EXiciuTE/Gaus-Beschleuniger/production/BOM_Overview.xlsx

Reference | Qty | Value | Footprint | Voltage | MPN | LCSC_Part_# | STATUS
A1 | 1 | Arduino_Nano_v3.x | Module:Arduino_Nano |  |  |  | home
BT1 | 1 | Battery | Connector_AMASS:AMASS_XT60-M_1x02_P7.20mm_Vertical |  |  | C5334533 | home
C1,C2,C3,C4,C5,C6,C7,C8 | 8 | 1000uF | Capacitor_THT:CP_Radial_D35.0mm_P10.00mm_SnapIn |  | ESMR401VSN102MA50S | C1589731 | digikey
C9,C13 | 2 | 100n | Capacitor_SMD:C_0805_2012Metric_Pad1.18x1.45mm_HandSolder | 100V | CL21B104KCFNNNE | C28233 | PCBA
C10,C11,C12 | 3 | 1u | Capacitor_SMD:C_1206_3216Metric_Pad1.33x1.80mm_HandSolder | 100V | CL31B105KCHNNNE | C13832 | PCBA
C14,C15 | 2 | 22u | Capacitor_SMD:C_0805_2012Metric_Pad1.18x1.45mm_HandSolder | 10V | GRM21BR61A226ME44L | C441864 | PCBA
C16,C17,C18,C19,C20,C21 | 6 | 4u7 | Capacitor_SMD:C_1206_3216Metric_Pad1.33x1.80mm_HandSolder | 50V | CL31B475KBHNNNE | C51205 | PCBA
C22 | 1 | 100p | Capacitor_SMD:C_0603_1608Metric_Pad1.08x0.95mm_HandSolder | 50V | C0603C101J5GACTU | C2167328 | digikey
C23,C24,C25 | 3 | 100u 35V | Capacitor_THT:CP_Radial_D6.3mm_P2.50mm |  | 35ZLH100MEFC6.3X11 | C109392 | PCBA
C26 | 1 | 1000pF | Capacitor_SMD:C_1206_3216Metric_Pad1.33x1.80mm_HandSolder | 1000V | CC1206KKX7RDBB102 | C23631 | digikey
D1 | 1 | SM6T36A | Diode_SMD:D_SMB |  | SM6T36A | C7436537 | digikey
D2,D3,D6,D9,D11,D13,D17,D19,D20,D21,D22 | 11 | LED red | LED_THT:LED_D5.0mm |  | 151051RS11000 |  | digikey
D4,D15 | 2 | Q_SCR_KAG | Package_TO_SOT_THT:TO-247-3_Horizontal_TabDown |  | 70TPS12 | C335786 | home
D5,D25 | 2 | MURS160 | Diode_SMD:D_SMB_Handsoldering |  | MURS160 | C16378 | PCBA
D7,D8,D10,D12 | 4 | 940nm | LED_THT:LED_SideEmitter_Rectangular_W4.5mm_H1.6mm |  | LTE-302-M | C6980548 | digikey
D16 | 1 | US2M_HF | Diode_SMD:D_SMB_Handsoldering | 1000V | US2M_HF | C17247425 | digikey
D18 | 1 | 1N5340BG 6V | Diode_THT:D_DO-201_P15.24mm_Horizontal |  | 1N5340BG | C232444 | digikey
D24 | 1 | D_Schottky | Diode_SMD:D_SOD-123 |  | B0540W-7-F | C154764 | digikey
J1,J2,J3,J4,J5,J6 | 6 | Conn_01x02 | Connector_PinHeader_2.54mm:PinHeader_1x02_P2.54mm_Vertical,Connector_Wire:SolderWire-1sqmm_1x02_P5.4mm_D1.4mm_OD2.7mm |  |  |  | home
J7 | 1 | Screw_Terminal_01x02 | TerminalBlock_Phoenix:TerminalBlock_Phoenix_MKDS-1,5-2-5.08_1x02_P5.08mm_Horizontal |  |  |  | home
J8,J10 | 2 | Conn_01x04 | Connector_PinHeader_2.54mm:PinHeader_1x04_P2.54mm_Vertical |  |  |  | home
J9,J11,J13 | 3 | Conn_01x03 | Connector_PinHeader_2.54mm:PinHeader_1x03_P2.54mm_Vertical |  |  |  | home
J12 | 1 | Conn_01x04_Socket | Connector_PinSocket_2.54mm:PinSocket_1x04_P2.54mm_Vertical |  |  |  | home
L1 | 1 | L | Inductor_SMD:L_Bourns_SRN6045TA |  | SRN6045-150M | C3224592 | digikey
Q1,Q2 | 2 | Q_NMOS_GDS | Package_TO_SOT_SMD:SOT-223-3_TabPin2 |  | IPN60R3K4CEATMA1 |  | digikey
Q3,Q4,Q5,Q6 | 4 | 940nm | OptoDevice:Osram_LPT80A |  | PT908-7B-F | C17179478 | digikey
Q9 | 1 | IRF7493 | Package_SO:SOIC-8_3.9x4.9mm_P1.27mm |  | IRF7493 | C13914 | digikey
R1,R3,R6,R7,R10,R11,R13,R15,R17,R20,R24,R30,R31,R32,R33,R34,R35,R36,R37,R38,R41,R42 | 22 | 10k | Resistor_SMD:R_0805_2012Metric_Pad1.20x1.40mm_HandSolder |  | RC0805FR-0710KL | C84376 | PCBA
R2 | 1 | 88k7 | Resistor_SMD:R_0805_2012Metric_Pad1.20x1.40mm_HandSolder |  | RC0805FR-0788K7L | C273823 | PCBA
R4,R9,R18,R19 | 4 | 470k | Resistor_THT:R_Axial_DIN0207_L6.3mm_D2.5mm_P10.16mm_Horizontal |  | RNV14FAL470K | C2642472 | digikey
R5,R12,R14,R16,R39,R40 | 6 | 1k | Resistor_SMD:R_0805_2012Metric_Pad1.20x1.40mm_HandSolder |  | RC0805FR-101KL | C5842544 | digikey
R8,R23 | 2 | 2k | Resistor_THT:R_Axial_Power_L48.0mm_W12.5mm_P60.96mm |  | SQP10AJB-2K | C20166277 | digikey
R25 | 1 | 22k1 | Resistor_SMD:R_0805_2012Metric_Pad1.20x1.40mm_HandSolder |  | AC0805FR-0722K1L | C228640 | PCBA
R26 | 1 | 12mR | Resistor_SMD:R_1206_3216Metric_Pad1.30x1.75mm_HandSolder |  | PA1206FRE7W0R012Z | C7023635 | digikey
R27 | 1 | 43k | Resistor_SMD:R_0603_1608Metric_Pad0.98x0.95mm_HandSolder |  | RC0603FR-0743KL | C137719 | PCBA
R28 | 1 | 2k49 | Resistor_SMD:R_0603_1608Metric_Pad0.98x0.95mm_HandSolder |  | RC0603FR-132K49L | C4210186 | digikey
R29 | 1 | 60k4 | Resistor_SMD:R_0603_1608Metric_Pad0.98x0.95mm_HandSolder |  | RC0603FR-0760K4L | C165742 | PCBA
SW1,SW2 | 2 | SW_SPDT | 00_Library:Toggle_Switch_SPDT_PCB |  | SW-T2-2E-A-A2-M1 | C4950128 | digikey
SW4,SW5,SW6 | 3 | SW_Omron_B3FS | Button_Switch_THT:SW_TH_Tactile_Omron_B3F-10xx |  | B3F-1000 | C93157 | digikey
TR1 | 1 | Wuerth_750032052 | 00_Library:T_Wurth_WE-FB3751-EFD20 |  | 750032052 |  | digikey
U1 | 1 | LMR50410 | Package_TO_SOT_SMD:SOT-23-6 |  | LMR50410XDBVR | C2841056 | PCBA
U2 | 1 | LT3750 | Package_SO:MSOP-10_3x3mm_P0.5mm |  | LT3750 | C580129 | PCBA
Display | 1 |  |  |  |  | Kosten
Spannungsanzeige | 1 |  |  |  |  | PCB+PCBA | 110 € | mit allem
 |  |  |  |  |  | Digikey
 |  |  |  |  |  | Aliexpress
