EXiciuTE/Gaus-Beschleuniger/production/not_on_lcsc.xlsx

nicht verfügbar
D16
R4,R9,R18,R19
R8,R23
R26
R28
SW1,SW2
rote leds
D7,D8,D10,D12
Q1,Q2
Q3,Q4,Q5,Q6
TR1
die dicken Cs
lieber manuell machen, da pro komponente 2,60€ anfallen für PNP wechsel
C26
D1
D18
D24
L1
Q9
SW4,SW5,SW6
C22
