EXiciuTE/Gaus-Beschleuniger/toggle-switch-pcb-mounted-spdt-dpdt-3way-1.snapshot.20/Mounting Plyate.step

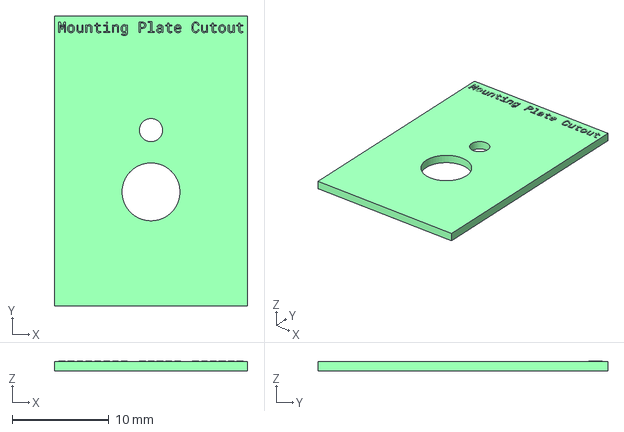
[picture p5: CAD file, 2025-11-15]
toggle-switch-pcb-mounted-spdt-dpdt-3way-1.snapshot.20/Mounting Plyate.step
20.0 x 30.0 x 1.05 mm
