EXiciuTE/Gaus-Beschleuniger/Gaus-Beschleuniger.kicad_pcb

## KiCad design Gaus-Beschleuniger.kicad_pcb (2025-11-22)

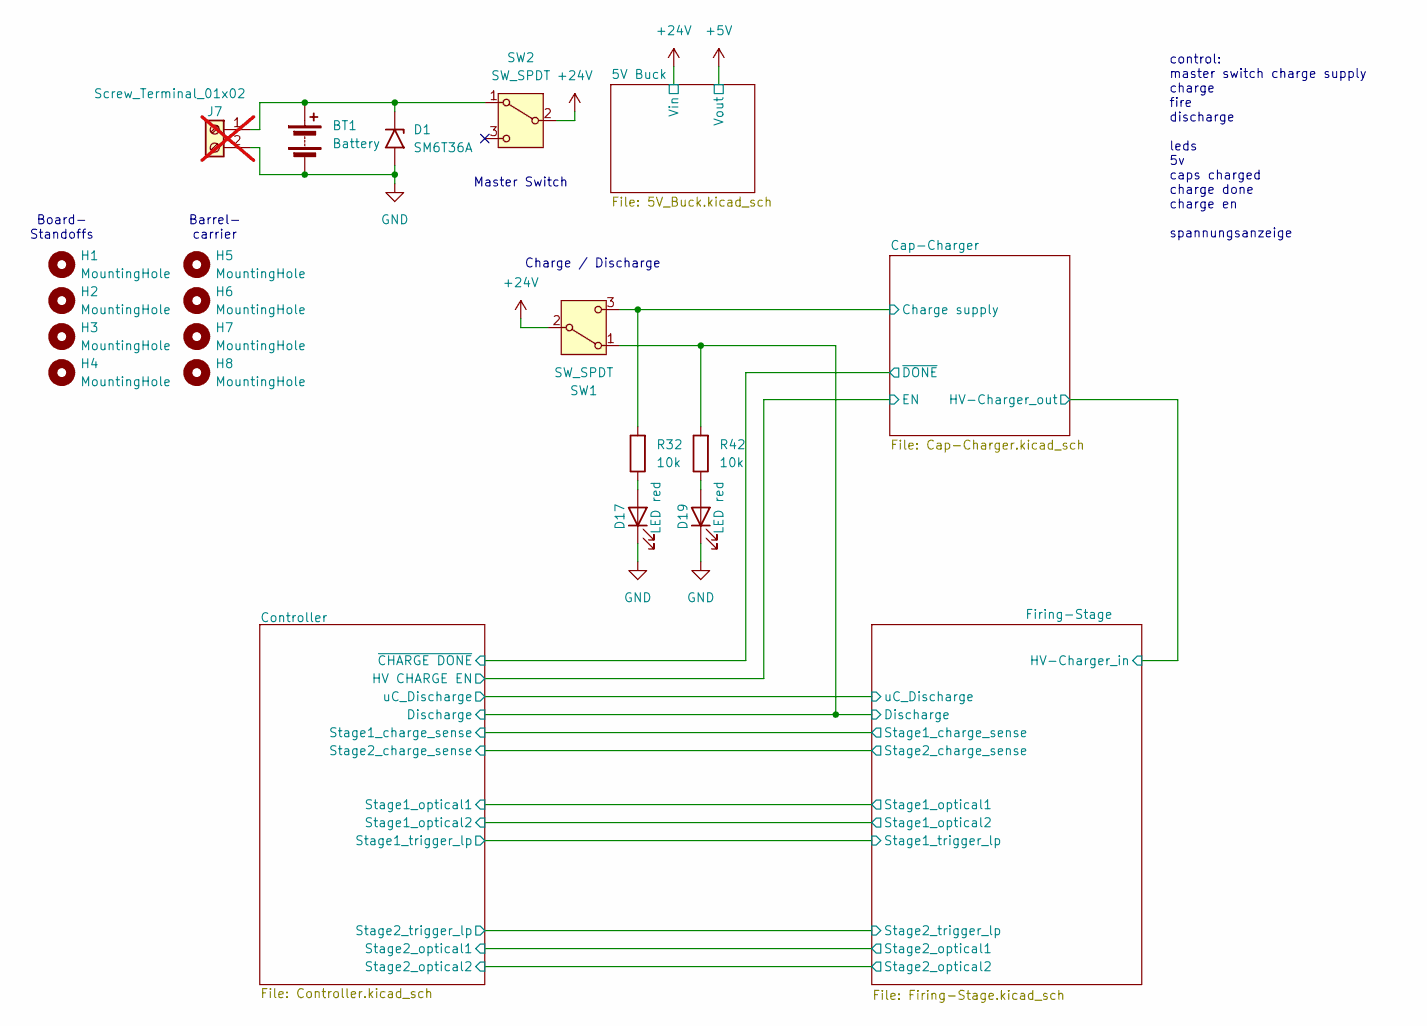
[picture p6: schematic Gaus-Beschleuniger.kicad_sch]

Parts:
BT1: Battery; AMASS_XT60-M_1x02_P7.20mm_Vertical; LCSC_Part_# C5334533
D1: SM6T36A; D_SMB; MPN SM6T36A; LCSC_Part_# C7436537
D17, D19: LED red; LED_D5.0mm; MPN 151051RS11000
H1, H2, H3, H4: MountingHole; MountingHole_4.3mm_M4_DIN965
H5, H6, H7, H8: MountingHole; MountingHole_3.2mm_M3_DIN965
J7: Screw_Terminal_01x02; TerminalBlock_Phoenix_MKDS-1,5-2-5.08_1x02_P5.08mm_Horizont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; not fitted
R32, R42: 10k; R_0805_2012Metric_Pad1.20x1.40mm_HandSolder; MPN RC0805FR-0710KL; LCSC_Part_# C84376
SW1, SW2: SW_SPDT; Toggle_Switch_SPDT_PCB; MPN SW-T2-2E-A-A2-M1; LCSC_Part_# C4950128

Connections:
+24V: SW1.2 (B), SW2.2 (B); also elsewhere on the board
/Cap-Charger/Charge supply: R32.2, SW1.3 (C); also elsewhere on the board
/Controller/Discharge: R42.2, SW1.1 (A); also elsewhere on the board
GND: BT1.2 (-), D1.2 (A2), D17.1 (K), D19.1 (K), J7.2; also elsewhere on the board
unnamed: BT1.1 (+), D1.1 (A1), J7.1, SW2.1 (A)
unnamed: D17.2 (A), R32.1
unnamed: D19.2 (A), R42.1

Notes on the sheet:
Board- Standoffs
control: master switch charge supply charge fire discharge leds 5v caps charged charge done charge en spannungsanzeige
Master Switch
Barrel- carrier
Charge / Discharge

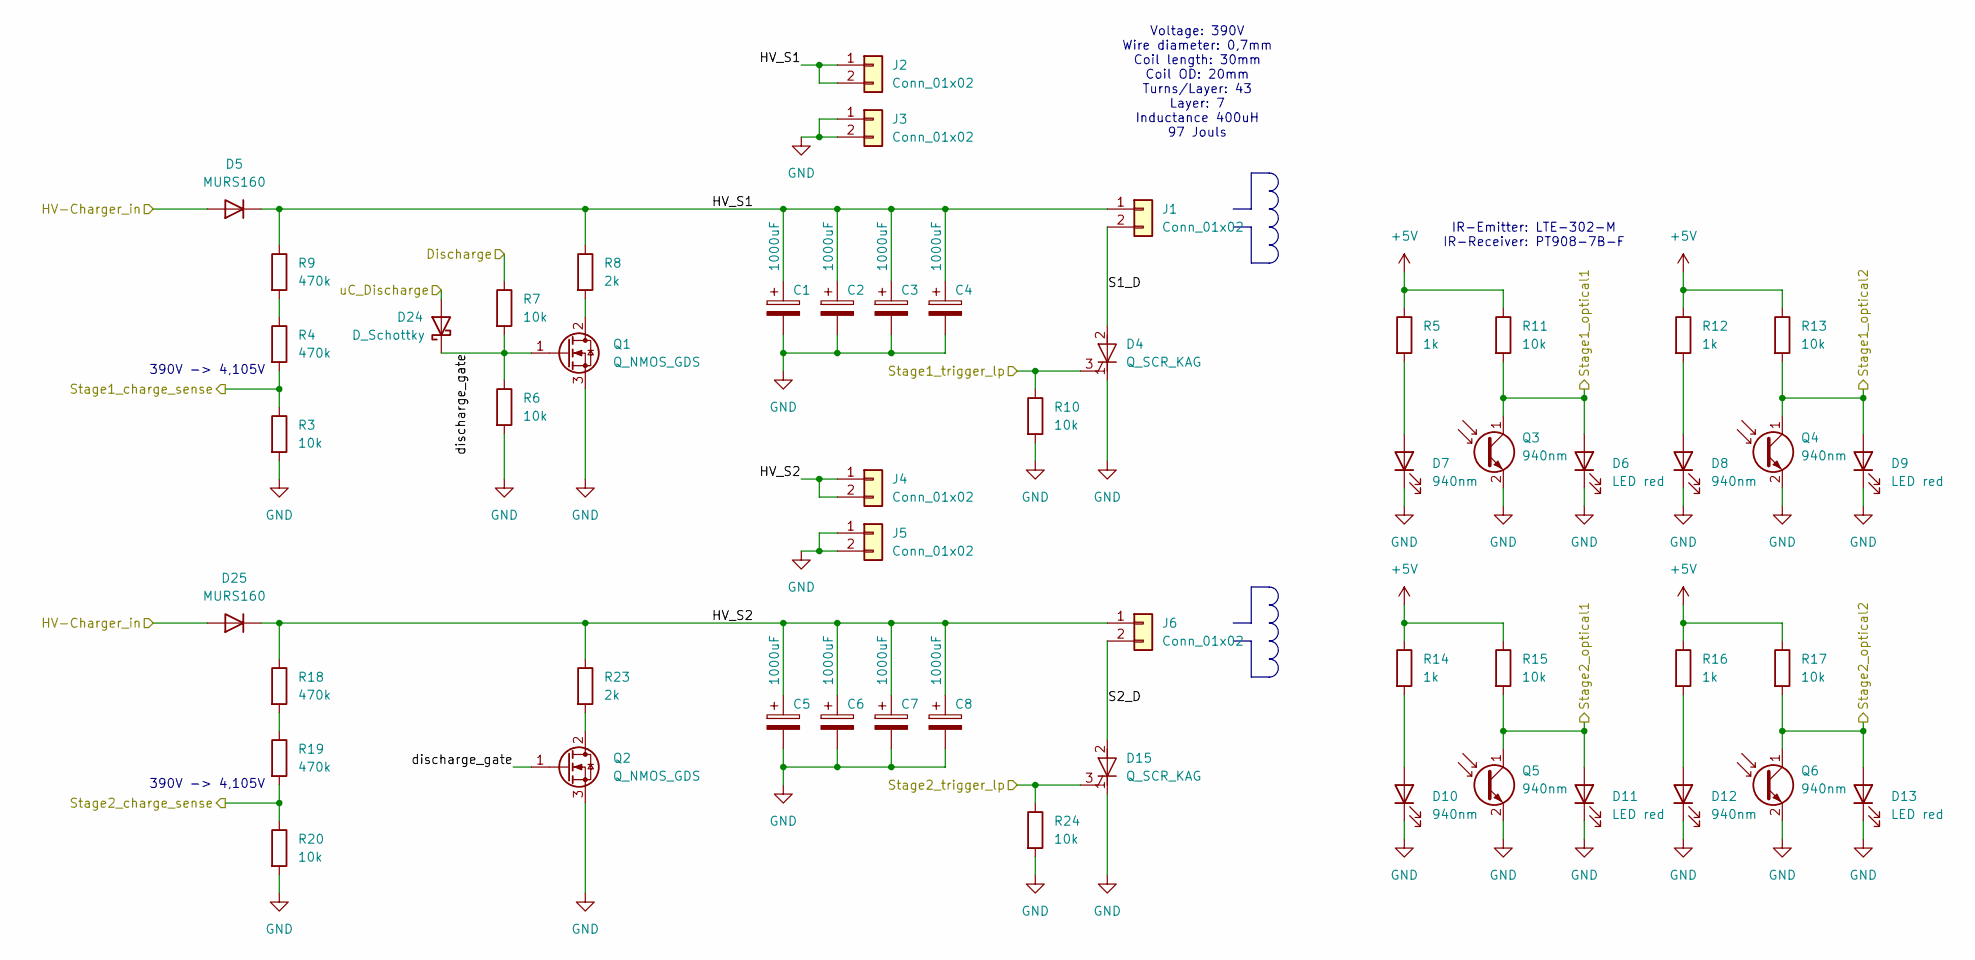
[picture p7: schematic Firing-Stage.kicad_sch]

Parts:
C1, C2, C3, C4, C5, C6, C7, C8: 1000uF; CP_Radial_D35.0mm_P10.00mm_SnapIn; MPN ESMR401VSN102MA50S; LCSC_Part_# C1589731
D4, D15: Q_SCR_KAG; TO-247-3_Horizontal_TabDown; MPN 70TPS12; LCSC_Part_# C335786
D5, D25: MURS160; D_SMB_Handsoldering; MPN MURS160; LCSC_Part_# C16378
D6, D9, D11, D13: LED red; LED_D5.0mm; MPN 151051RS11000
D7, D8, D10, D12: 940nm; LED_SideEmitter_Rectangular_W4.5mm_H1.6mm; MPN LTE-302-M; LCSC_Part_# C6980548
D24: D_Schottky; D_SOD-123; MPN B0540W-7-F; LCSC_Part_# C154764
J1, J6: Conn_01x02; SolderWire-1sqmm_1x02_P5.4mm_D1.4mm_OD2.7mm
J2, J3, J4, J5: Conn_01x02; PinHeader_1x02_P2.54mm_Vertical
Q1, Q2: Q_NMOS_GDS; SOT-223-3_TabPin2; MPN IPN60R3K4CEATMA1
Q3, Q4, Q5, Q6: 940nm; Osram_LPT80A; MPN PT908-7B-F; LCSC_Part_# C17179478
R3, R6, R7, R10, R11, R13, R15, R17, R20, R24: 10k; R_0805_2012Metric_Pad1.20x1.40mm_HandSolder; MPN RC0805FR-0710KL; LCSC_Part_# C84376
R4, R9, R18, R19: 470k; R_Axial_DIN0207_L6.3mm_D2.5mm_P10.16mm_Horizontal; MPN RNV14FAL470K; LCSC_Part_# C2642472
R5, R12, R14, R16: 1k; R_0805_2012Metric_Pad1.20x1.40mm_HandSolder; MPN RC0805FR-101KL; LCSC_Part_# C5842544
R8, R23: 2k; R_Axial_Power_L48.0mm_W12.5mm_P60.96mm; MPN SQP10AJB-2K; LCSC_Part_# C20166277

Connections:
+5V: R5.1, R11.1, R12.1, R13.1, R14.1, R15.1, R16.1, R17.1; also elsewhere on the board
/Cap-Charger/HV-Charger_out: D5.2 (A), D25.2 (A); also elsewhere on the board
/Controller/Discharge: R7.1; also elsewhere on the board
/Controller/Stage1_charge_sense: R3.1, R4.2; also elsewhere on the board
/Controller/Stage1_optical1: D6.2 (A), Q3.1 (C), R11.2; also elsewhere on the board
/Controller/Stage1_optical2: D9.2 (A), Q4.1 (C), R13.2; also elsewhere on the board
/Controller/Stage1_trigger_lp: D4.3 (G), R10.1; also elsewhere on the board
/Controller/Stage2_charge_sense: R19.2, R20.1; also elsewhere on the board
/Controller/Stage2_optical1: D11.2 (A), Q5.1 (C), R15.2; also elsewhere on the board
/Controller/Stage2_optical2: D13.2 (A), Q6.1 (C), R17.2; also elsewhere on the board
/Controller/Stage2_trigger_lp: D15.3 (G), R24.1; also elsewhere on the board
/Controller/uC_Discharge: D24.2 (A); also elsewhere on the board
/Firing-Stage/HV_S1: C1.1, C2.1, C3.1, C4.1, D5.1 (K), J1.1, J2.1, J2.2, R8.1, R9.1
/Firing-Stage/HV_S2: C5.1, C6.1, C7.1, C8.1, D25.1 (K), J4.1, J4.2, J6.1, R18.1, R23.1
/Firing-Stage/S1_D: D4.2 (A), J1.2
/Firing-Stage/S2_D: D15.2 (A), J6.2
/Firing-Stage/discharge_gate: D24.1 (K), Q1.1 (G), Q2.1 (G), R6.1, R7.2
GND: C1.2, C2.2, C3.2, C4.2, C5.2, C6.2, C7.2, C8.2, D4.1 (K), D6.1 (K), D7.1 (K), D8.1 (K), D9.1 (K), D10.1 (K), D11.1 (K), D12.1 (K), D13.1 (K), D15.1 (K), J3.1, J3.2, J5.1, J5.2, Q1.3 (S), Q2.3 (S), Q3.2 (E), Q4.2 (E), Q5.2 (E), Q6.2 (E), R3.2, R6.2, R10.2, R20.2, R24.2; also elsewhere on the board
unnamed: D7.2 (A), R5.2
unnamed: D8.2 (A), R12.2
unnamed: D10.2 (A), R14.2
unnamed: D12.2 (A), R16.2
unnamed: Q1.2 (D), R8.2
unnamed: Q2.2 (D), R23.2
unnamed: R4.1, R9.2
unnamed: R18.2, R19.1

Notes on the sheet:
IR-Emitter: LTE-302-M IR-Receiver: PT908-7B-F
Voltage: 390V Wire diameter: 0,7mm Coil length: 30mm Coil OD: 20mm Turns/Layer: 43 Layer: 7 Inductance 400uH 97 Jouls
390V -> 4,105V

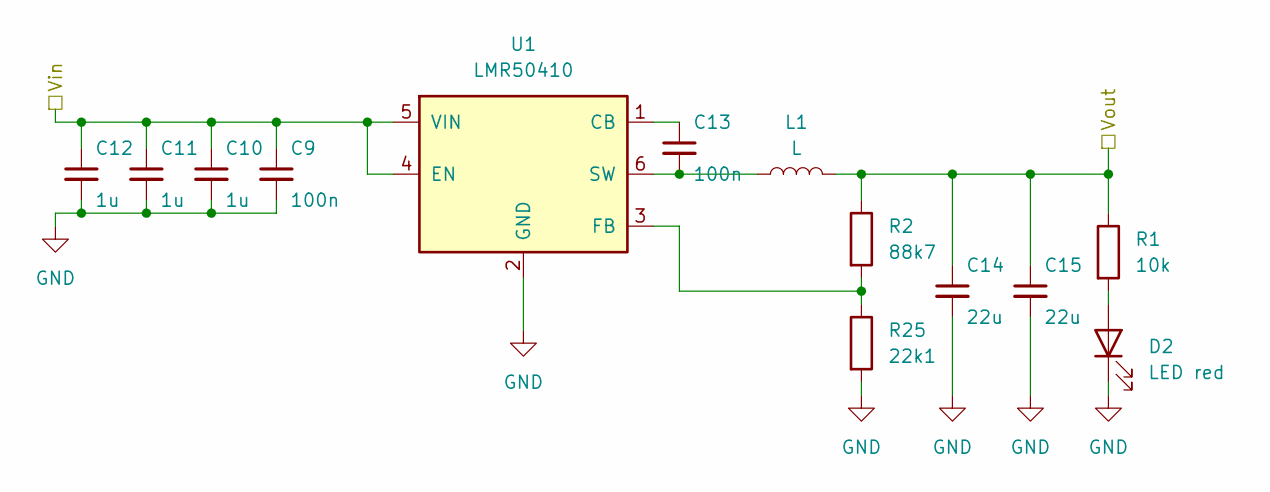
[picture p8: schematic 5V_Buck.kicad_sch]

Parts:
C9, C13: 100n; C_0805_2012Metric_Pad1.18x1.45mm_HandSolder; Voltage 100V; MPN CL21B104KCFNNNE; LCSC_Part_# C28233
C10, C11, C12: 1u; C_1206_3216Metric_Pad1.33x1.80mm_HandSolder; Voltage 100V; MPN CL31B105KCHNNNE; LCSC_Part_# C13832
C14, C15: 22u; C_0805_2012Metric_Pad1.18x1.45mm_HandSolder; Voltage 10V; MPN GRM21BR61A226ME44L; LCSC_Part_# C441864
D2: LED red; LED_D5.0mm; MPN 151051RS11000
L1: L; L_Bourns_SRN6045TA; MPN SRN6045-150M; LCSC_Part_# C3224592
R1: 10k; R_0805_2012Metric_Pad1.20x1.40mm_HandSolder; MPN RC0805FR-0710KL; LCSC_Part_# C84376
R2: 88k7; R_0805_2012Metric_Pad1.20x1.40mm_HandSolder; MPN RC0805FR-0788K7L; LCSC_Part_# C273823
R25: 22k1; R_0805_2012Metric_Pad1.20x1.40mm_HandSolder; MPN AC0805FR-0722K1L; LCSC_Part_# C228640
U1: LMR50410; SOT-23-6; MPN LMR50410XDBVR; LCSC_Part_# C2841056

Connections:
+5V: C14.1, C15.1, L1.2, R1.1, R2.1; also elsewhere on the board
+24V: C9.1, C10.1, C11.1, C12.1, U1.4 (EN), U1.5 (VIN); also elsewhere on the board
GND: C9.2, C10.2, C11.2, C12.2, C14.2, C15.2, D2.1 (K), R25.2, U1.2 (GND); also elsewhere on the board
unnamed: D2.2 (A), R1.2
unnamed: C13.1, U1.1 (CB)
unnamed: R2.2, R25.1, U1.3 (FB)
unnamed: C13.2, L1.1, U1.6 (SW)

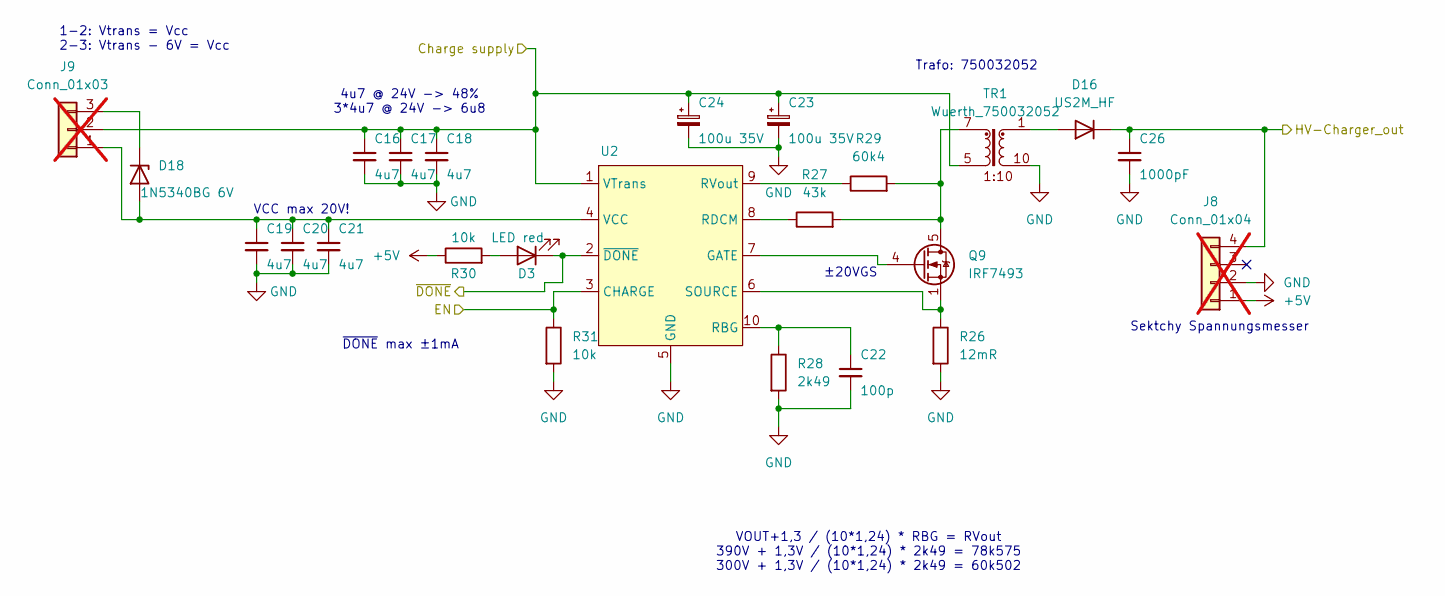
[picture p9: schematic Cap-Charger.kicad_sch]

Parts:
C16, C17, C18, C19, C20, C21: 4u7; C_1206_3216Metric_Pad1.33x1.80mm_HandSolder; Voltage 50V; MPN CL31B475KBHNNNE; LCSC_Part_# C51205
C22: 100p; C_0603_1608Metric_Pad1.08x0.95mm_HandSolder; Voltage 50V; MPN C0603C101J5GACTU; LCSC_Part_# C2167328
C23, C24: 100u 35V; CP_Radial_D6.3mm_P2.50mm; MPN 35ZLH100MEFC6.3X11; LCSC_Part_# C109392
C26: 1000pF; C_1206_3216Metric_Pad1.33x1.80mm_HandSolder; Voltage 1000V; MPN CC1206KKX7RDBB102; LCSC_Part_# C23631
D3: LED red; LED_D5.0mm; MPN 151051RS11000
D16: US2M_HF; D_SMB_Handsoldering; Voltage 1000V; MPN US2M_HF; LCSC_Part_# C17247425
D18: 1N5340BG 6V; D_DO-201_P15.24mm_Horizontal; MPN 1N5340BG; LCSC_Part_# C232444
J8: Conn_01x04; PinHeader_1x04_P2.54mm_Vertical; not fitted
J9: Conn_01x03; PinHeader_1x03_P2.54mm_Vertical; not fitted
Q9: IRF7493; SOIC-8_3.9x4.9mm_P1.27mm; MPN IRF7493; LCSC_Part_# C13914
R26: 12mR; R_1206_3216Metric_Pad1.30x1.75mm_HandSolder; MPN PA1206FRE7W0R012Z; LCSC_Part_# C7023635
R27: 43k; R_0603_1608Metric_Pad0.98x0.95mm_HandSolder; MPN RC0603FR-0743KL; LCSC_Part_# C137719
R28: 2k49; R_0603_1608Metric_Pad0.98x0.95mm_HandSolder; MPN RC0603FR-132K49L; LCSC_Part_# C4210186
R29: 60k4; R_0603_1608Metric_Pad0.98x0.95mm_HandSolder; MPN RC0603FR-0760K4L; LCSC_Part_# C165742
R30, R31: 10k; R_0805_2012Metric_Pad1.20x1.40mm_HandSolder; MPN RC0805FR-0710KL; LCSC_Part_# C84376
TR1: Wuerth_750032052; T_Wurth_WE-FB3751-EFD20; MPN 750032052
U2: LT3750; MSOP-10_3x3mm_P0.5mm; MPN LT3750; LCSC_Part_# C580129

Connections:
+5V: J8.1, R30.1; also elsewhere on the board
/Cap-Charger/Charge supply: C16.1, C17.1, C18.1, C23.1, C24.1, J9.2, TR1.4, TR1.5, U2.1 (VTrans); also elsewhere on the board
/Cap-Charger/EN: R31.1, U2.3 (CHARGE); also elsewhere on the board
/Cap-Charger/HV-Charger_out: C26.1, D16.1 (K), J8.4; also elsewhere on the board
/Cap-Charger/~DONE: D3.1 (K), U2.2 (~DONE); also elsewhere on the board
GND: C16.2, C17.2, C18.2, C19.2, C20.2, C21.2, C22.2, C23.2, C24.2, C26.2, J8.2, R26.2, R28.2, R31.2, TR1.10, U2.5 (GND); also elsewhere on the board
unnamed: D3.2 (A), R30.2
unnamed: D16.2 (A), TR1.1
unnamed: C19.1, C20.1, C21.1, D18.2 (A), J9.1, U2.4 (VCC)
unnamed: D18.1 (K), J9.3
unnamed: Q9.5 (D), Q9.6 (D), Q9.7 (D), Q9.8 (D), R27.2, R29.2, TR1.6, TR1.7
unnamed: Q9.4 (G), U2.7 (GATE)
unnamed: C22.1, R28.1, U2.10 (RBG)
unnamed: R27.1, U2.8 (RDCM)
unnamed: R29.1, U2.9 (RVout)
unnamed: Q9.1 (S), Q9.2 (S), Q9.3 (S), R26.1, U2.6 (SOURCE)

Notes on the sheet:
1-2: Vtrans = Vcc 2-3: Vtrans - 6V = Vcc
~{DONE} max ±1mA
VCC max 20V!
±20VGS
VOUT+1,3 / (10*1,24) * RBG = RVout 390V + 1,3V / (10*1,24) * 2k49 = 78k575 300V + 1,3V / (10*1,24) * 2k49 = 60k502
4u7 @ 24V -> 48% 3*4u7 @ 24V -> 6u8
Trafo: 750032052
Sektchy Spannungsmesser

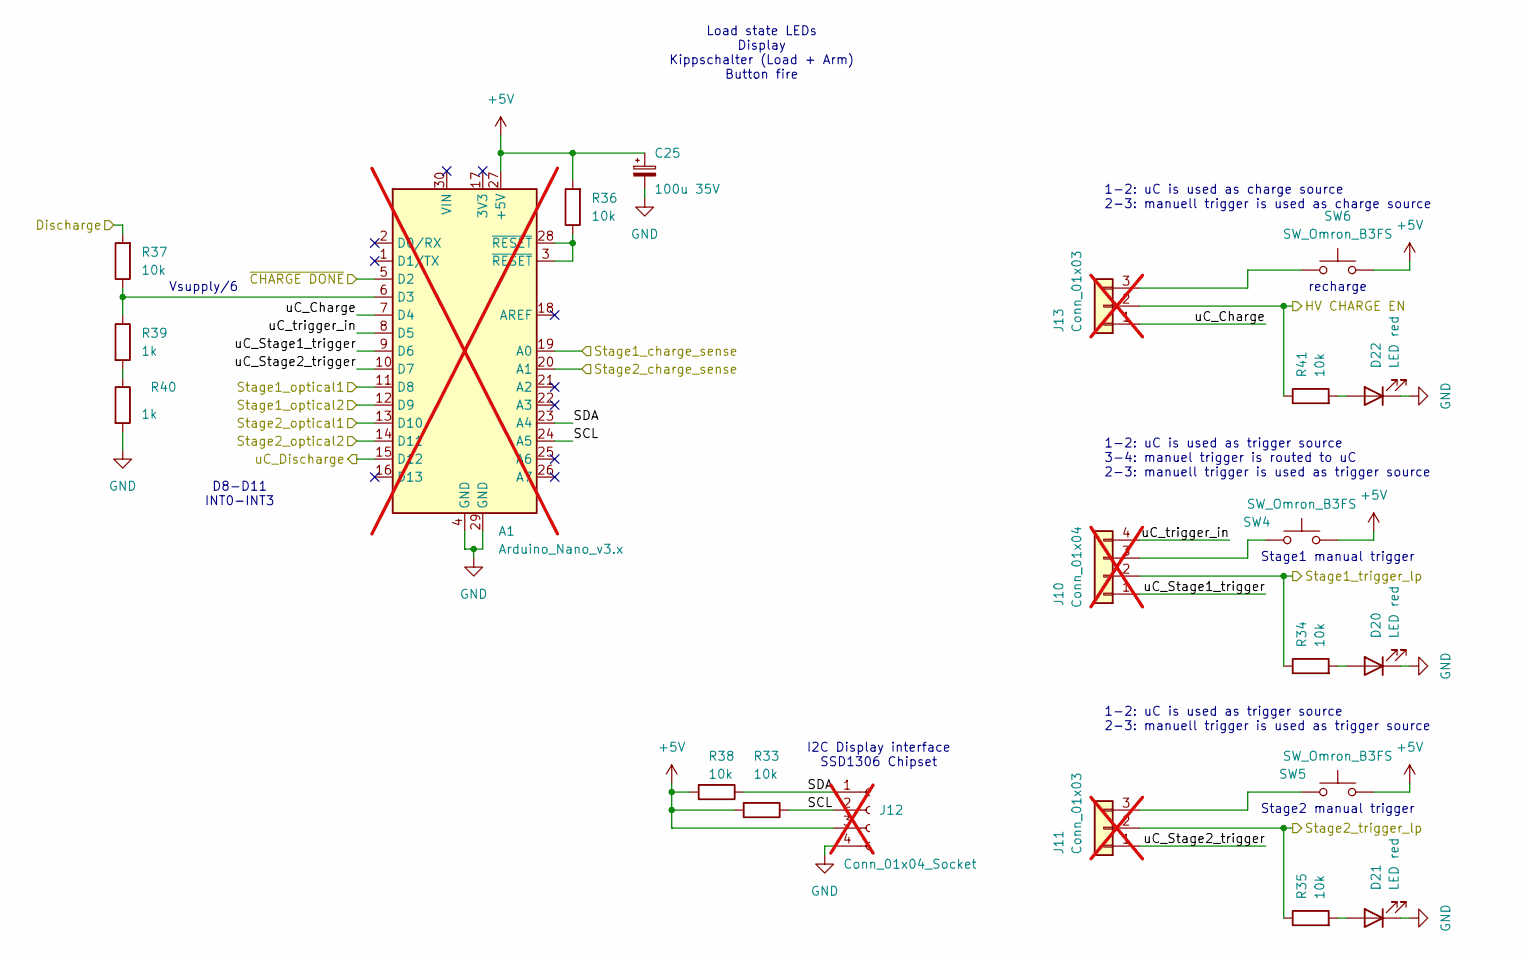
[picture p10: schematic Controller.kicad_sch]

Parts:
A1: Arduino_Nano_v3.x; Arduino_Nano; not fitted
C25: 100u 35V; CP_Radial_D6.3mm_P2.50mm; MPN 35ZLH100MEFC6.3X11; LCSC_Part_# C109392
D20, D21, D22: LED red; LED_D5.0mm; MPN 151051RS11000
J10: Conn_01x04; PinHeader_1x04_P2.54mm_Vertical; not fitted
J11, J13: Conn_01x03; PinHeader_1x03_P2.54mm_Vertical; not fitted
J12: Conn_01x04_Socket; PinSocket_1x04_P2.54mm_Vertical; not fitted
R33, R34, R35, R36, R37, R38, R41: 10k; R_0805_2012Metric_Pad1.20x1.40mm_HandSolder; MPN RC0805FR-0710KL; LCSC_Part_# C84376
R39, R40: 1k; R_0805_2012Metric_Pad1.20x1.40mm_HandSolder; MPN RC0805FR-101KL; LCSC_Part_# C5842544
SW4, SW5, SW6: SW_Omron_B3FS; SW_TH_Tactile_Omron_B3F-10xx; MPN B3F-1000; LCSC_Part_# C93157

Connections:
+5V: A1.27 (+5V), C25.1, J12.3, R33.2, R36.2, R38.2, SW4.2, SW5.2, SW6.2; also elsewhere on the board
/Cap-Charger/EN: J13.2, R41.1; also elsewhere on the board
/Cap-Charger/~DONE: A1.5 (D2); also elsewhere on the board
/Controller/Discharge: R37.2; also elsewhere on the board
/Controller/SCL: A1.24 (A5), J12.2, R33.1
/Controller/SDA: A1.23 (A4), J12.1, R38.1
/Controller/Stage1_charge_sense: A1.19 (A0); also elsewhere on the board
/Controller/Stage1_optical1: A1.11 (D8); also elsewhere on the board
/Controller/Stage1_optical2: A1.12 (D9); also elsewhere on the board
/Controller/Stage1_trigger_lp: J10.2, R34.1; also elsewhere on the board
/Controller/Stage2_charge_sense: A1.20 (A1); also elsewhere on the board
/Controller/Stage2_optical1: A1.13 (D10); also elsewhere on the board
/Controller/Stage2_optical2: A1.14 (D11); also elsewhere on the board
/Controller/Stage2_trigger_lp: J11.2, R35.1; also elsewhere on the board
/Controller/uC_Charge: A1.7 (D4), J13.1
/Controller/uC_Discharge: A1.15 (D12); also elsewhere on the board
/Controller/uC_Stage1_trigger: A1.9 (D6), J10.1
/Controller/uC_Stage2_trigger: A1.10 (D7), J11.1
/Controller/uC_trigger_in: A1.8 (D5), J10.4
GND: A1.4 (GND), A1.29 (GND), C25.2, D20.1 (K), D21.1 (K), D22.1 (K), J12.4, R40.2; also elsewhere on the board
unnamed: A1.6 (D3), R37.1, R39.1
unnamed: A1.3 (~RESET), A1.28 (~RESET), R36.1
unnamed: D20.2 (A), R34.2
unnamed: D21.2 (A), R35.2
unnamed: D22.2 (A), R41.2
unnamed: J10.3, SW4.1
unnamed: J11.3, SW5.1
unnamed: J13.3, SW6.1
unnamed: R39.2, R40.1

Notes on the sheet:
Vsupply/6
1-2: uC is used as charge source 2-3: manuell trigger is used as charge source
1-2: uC is used as trigger source 2-3: manuell trigger is used as trigger source
recharge
D8-D11 INT0-INT3
1-2: uC is used as trigger source 3-4: manuel trigger is routed to uC 2-3: manuell trigger is used as trigger source
Stage1 manual trigger
Stage2 manual trigger
I2C Display interface SSD1306 Chipset
Load state LEDs Display Kippschalter (Load + Arm) Button fire

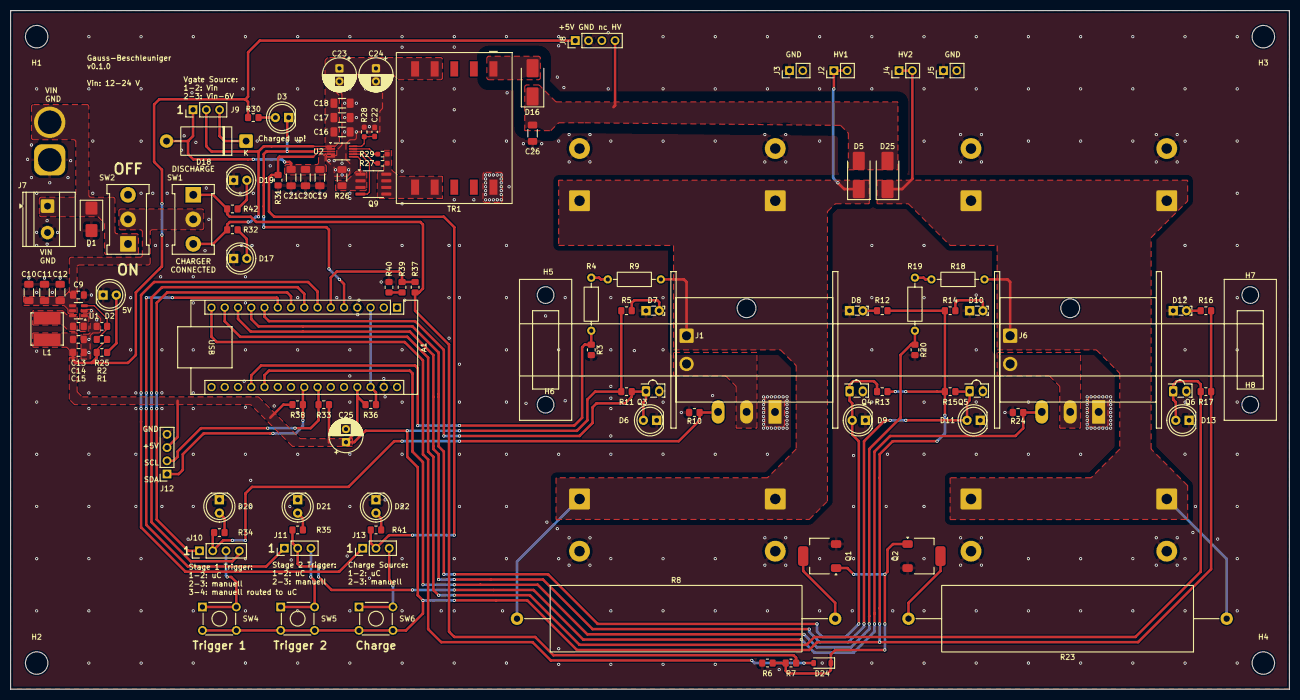
[picture p11: board Gaus-Beschleuniger.kicad_pcb from above]

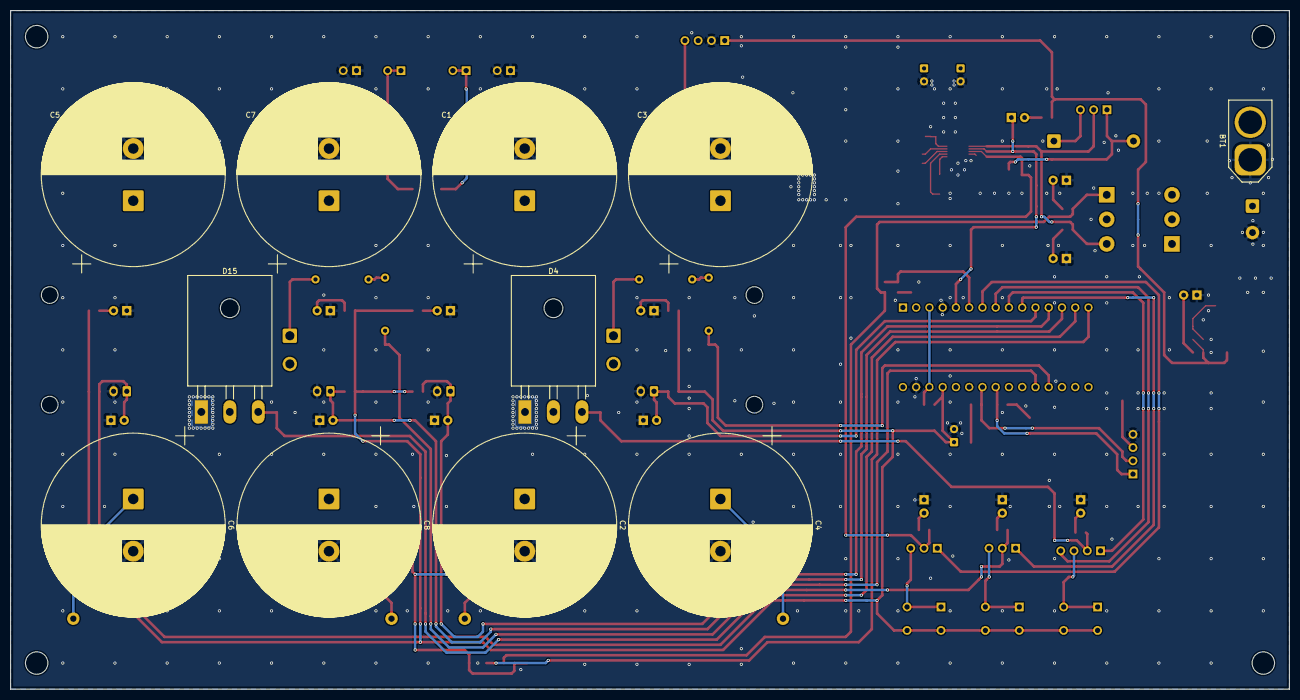
[picture p12: board Gaus-Beschleuniger.kicad_pcb from below]

Board: 2 copper layers, 245.0 x 130.0 mm, 128 parts (11 on the bottom side), 62 nets.
