EXiciuTE/Gaus-Beschleuniger/(commit log)

2025-11-15 init commit - schematic nearly done
    [Cap-Charger.kicad_sch, Coil gun 3.xlsx, Controller.kicad_sch, Firing-Stage.kicad_sch, Gaus-Beschleuniger.kicad_pcb, Gaus-Beschleuniger.kicad_sch, LV-Reg.kicad_sch, Mounting Plyate.step]
2025-11-17 rough placement
    [5V_Buck.kicad_sch, Cap-Charger.kicad_sch, Controller.kicad_sch, Firing-Stage.kicad_sch, Gaus-Beschleuniger.kicad_pcb, Gaus-Beschleuniger.kicad_sch]
2025-11-18 start layout
    [Cap-Charger.kicad_sch, Firing-Stage.kicad_sch, Gaus-Beschleuniger.kicad_pcb]
2025-11-19 layout weiter
    [Firing-Stage.kicad_sch, Gaus-Beschleuniger.kicad_pcb]
2025-11-19 firing routing, uC routing done
    [Controller.kicad_sch, Gaus-Beschleuniger.kicad_pcb]
2025-11-20 placement and routing done drc errors, stiching vias and polish next
    [Gaus-Beschleuniger.kicad_pcb, Gaus-Beschleuniger.kicad_sch]
2025-11-21 Layout finished
    [Gaus-Beschleuniger.kicad_pcb, Gaus-Beschleuniger.kicad_sch]
2025-11-21 now with gerber files :)
    [Gaus-Beschleuniger-B_Cu.gbl, Gaus-Beschleuniger-B_Mask.gbs, Gaus-Beschleuniger-B_Paste.gbp, Gaus-Beschleuniger-B_Silkscreen.gbo, Gaus-Beschleuniger-Edge_Cuts.gm1, Gaus-Beschleuniger-F_Cu.gtl, Gaus-Beschleuniger-F_Mask.gts, Gaus-Beschleuniger-F_Paste.gtp]
2025-11-22 update fab files ;/
    [5V_Buck.kicad_sch, BOM_Overview.xlsx, Cap-Charger.kicad_sch, Controller.kicad_sch, Firing-Stage.kicad_sch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]
